Crafitys/GameBoy-ESP32-Crafitys/GameBoy ESP32 BOM.pdf

## GameBoy ESP32 BOM

item | quantity | link TFT screen | 1 | https://www.amazon.fr/dp/B09Z299F3Q?ref=ppx_yo2ov_dt_b_fed_asin_title BMS battery boost module | 1 | https://www.amazon.fr/dp/B0C3V847G2?ref=ppx_yo2ov_dt_b_fed_asin_title ESP32 (node MCU) | 1 | https://www.amazon.fr/dp/B0DG8LRV2F?ref=ppx_yo2ov_dt_b_fed_asin_title PCB proto 3x7cm | 1 | https://www.amazon.fr/Aihasd-Prototype-Circuit-Imprim%C3%A9-Universelle/dp/B01GRJM6JA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 Switch on/off (SK12D07) | 1 | https://www.amazon.fr/dp/B09TK1GV8Q?ref=ppx_yo2ov_dt_b_fed_asin_title&th=1
battery lipo 3,7v 1100mAh | 1 | https://www.amazon.fr/EEMB-Batterie-Rechargeable-Navigation-Enregistreur/dp/B08FD39Y5R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
buttons | 8 | https://www.amazon.fr/DAOKAI-Interrupteur-Momentan%C3%A9-Composants-%C3%89lectroniques/dp/B09WVDCJVB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 wires | 1 | https://www.amazon.fr/TUOFENG-solide-fil-couleurs-diff%C3%A9rentes-raccordement/dp/B0CM5VY69G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 Screw 3x10 | 4 | https://www.amazon.fr/sourcing-map-Phillips-plastique-pi%C3%A8ces/dp/B015A394YE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 Screw 2x5 | 2 | https://www.amazon.fr/sourcingmap%C2%AE-plastique-cruciforme-croix-pi%C3%A8ces/dp/B012SY5Q3Q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
