Crafitys/GameBoy-ESP32-Crafitys/GameBoy-ESP32-Assembly tutorial.pdf

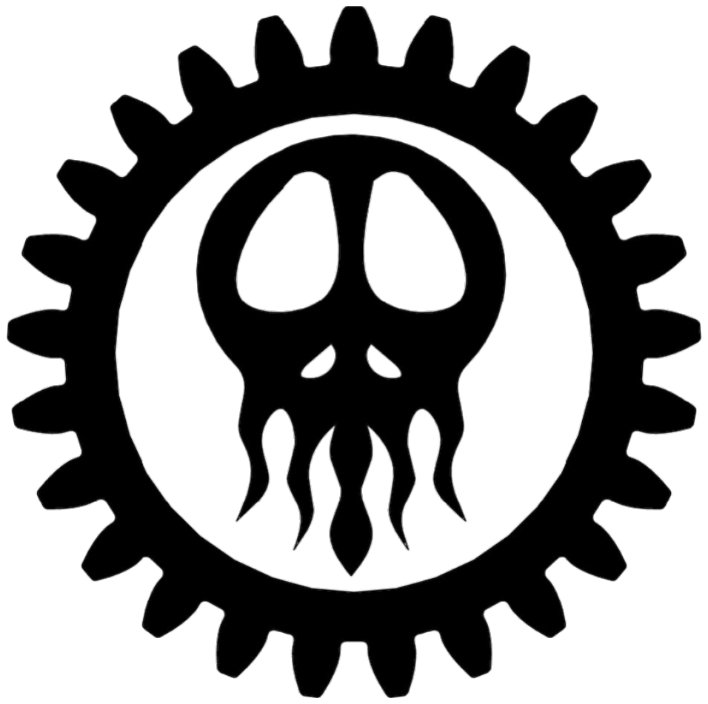
[picture p2: figure]

# Assembly instruction

## GameBoy ESP32

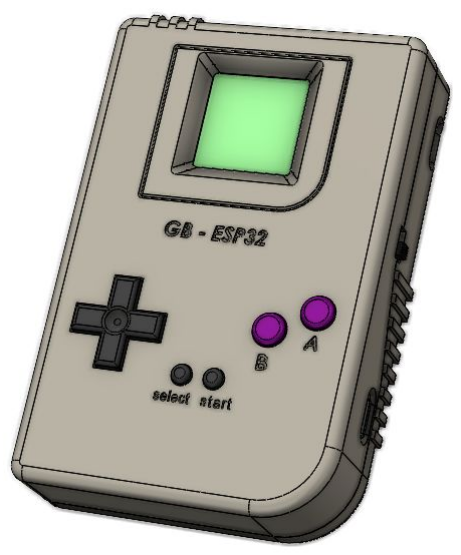
[picture p3: figure]
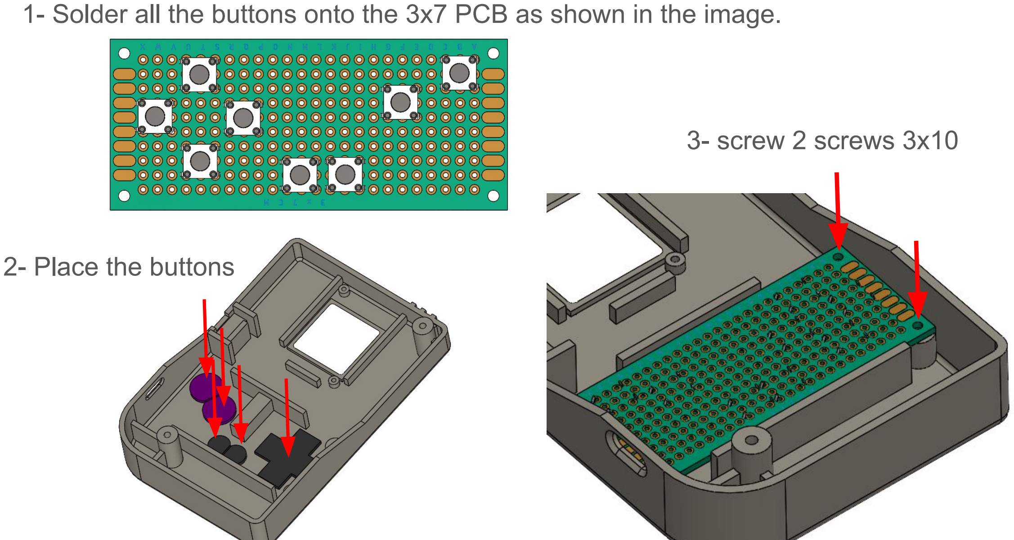
[picture p4: page 2]

1- Solder all the buttons onto the 3x7 PCB as shown in the image.

2- Place the buttons

3- screw 2 screws 3x10

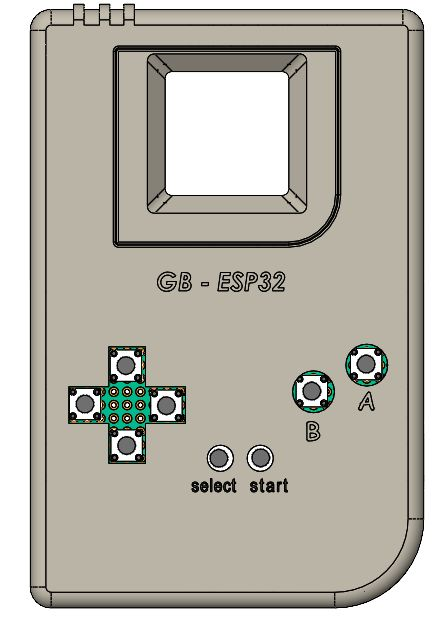
[picture p5: figure]

info: All buttons must be positioned opposite the housings as shown in the image.

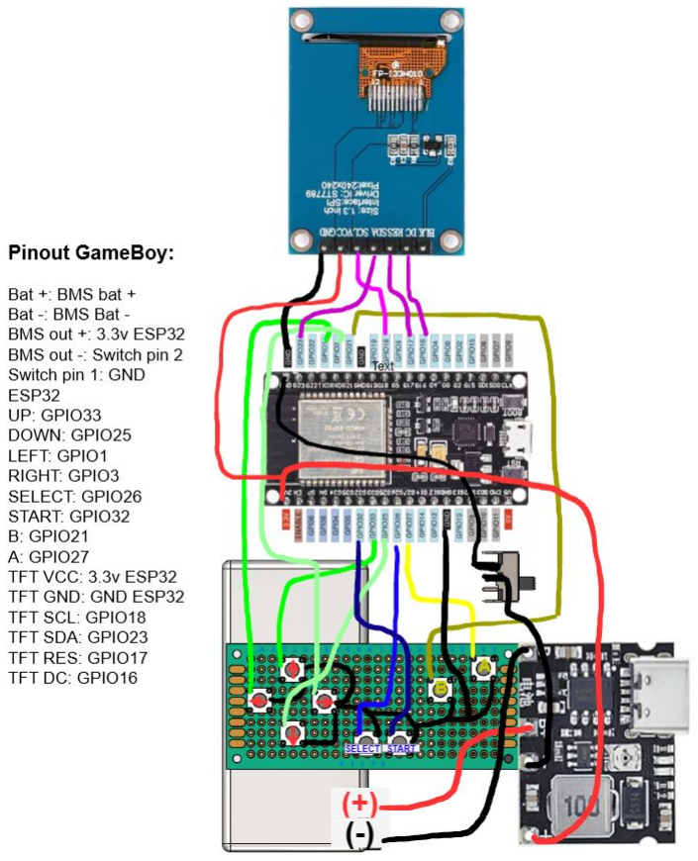
[picture p6: figure]

4- Solder all the remaining components together as
shown in the
"gameboy-esp32-wiring.pdf" guide.

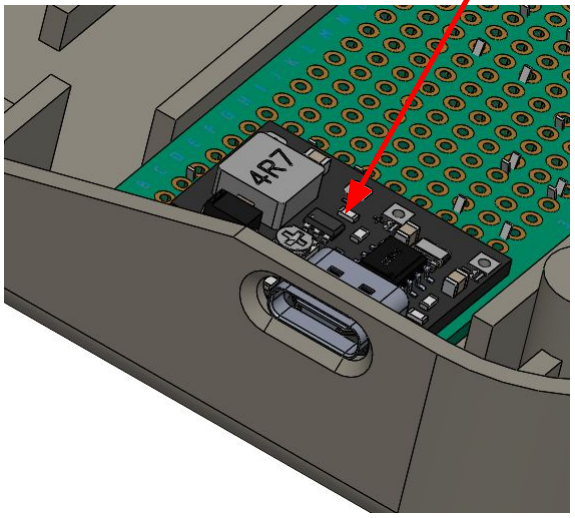
[picture p7: figure]

5- Glue the BMS module to the 3x7 PCB using a hot glue gun and pass it through the bottom USB-C slot.

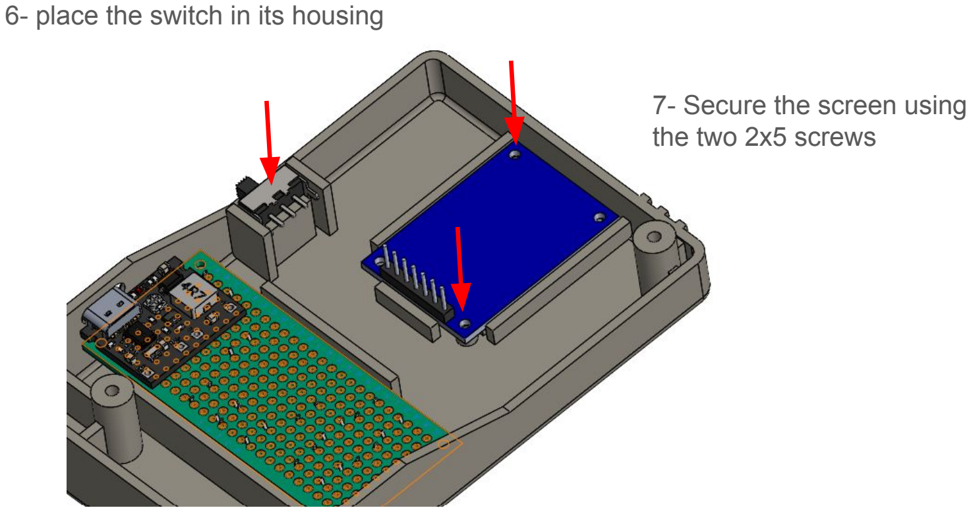
[picture p8: page 6]

6- place the switch in its housing

7- Secure the screen using the two 2x5 screws

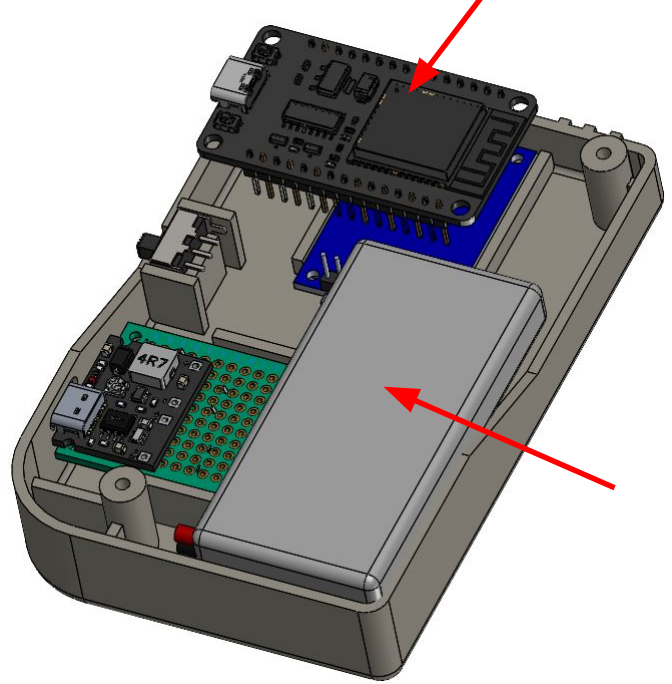
[picture p9: figure]

8- Make sure the ESP32
and the battery are
positioned as shown in the image.

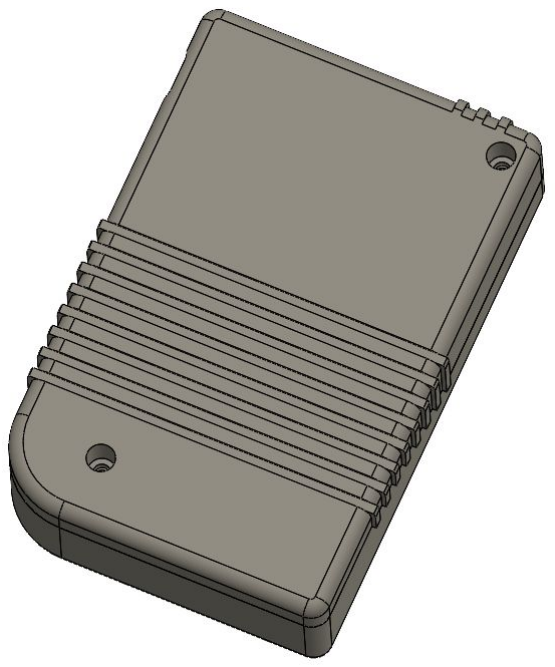
[picture p10: figure]

9- Screw in the last two
3x10 screws to close the
case, and arrange the wires so that none are pinched.

Important: If buttons
remain pressed or do
not activate correctly
after closing, slightly
loosen the 7x3 PCB to
relieve pressure.
