Crafitys/GameBoy-ESP32-Crafitys/(commit log)

2026-01-17 Revise README with new project details and setup
    Updated project description, hardware requirements, and wiring instructions.
2026-01-17 Update section title for wiring instructions
2026-01-17 Update README with link to Cults3D resources
    Added link to STL files and make files on Cults3D.
